OpenParol/OpenParol-Board/board/3dmodels/TLP293-4_LA-TP_E.step

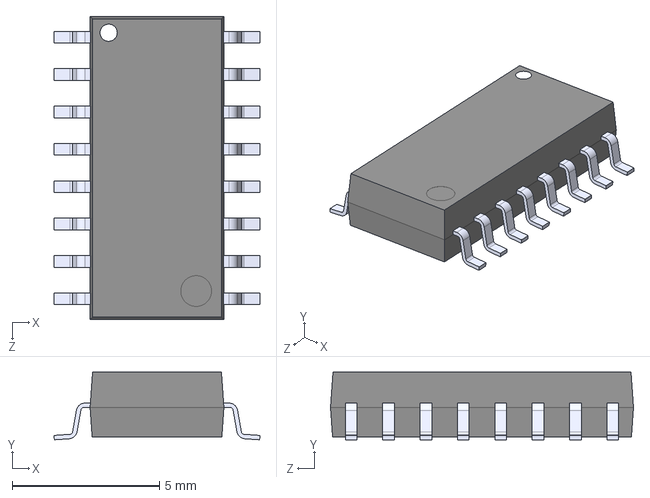
[picture p1: CAD file, 2026-10-22]
board/3dmodels/TLP293-4_LA-TP_E.step
7.00 x 2.30 x 10.3 mm
