OpenParol/OpenParol-Board/board/3dmodels/TLP281-4.step

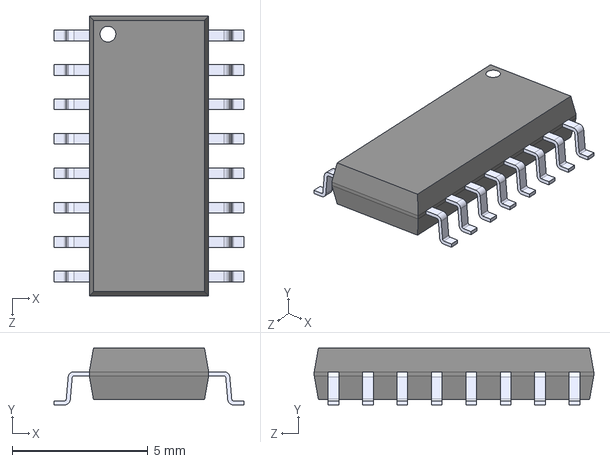
[picture p2: CAD file, 2026-10-22]
board/3dmodels/TLP281-4.step
7.00 x 2.10 x 10.3 mm
