OpenParol/OpenParol-Board/Board/3dmodels/ACT45B-510-2P-TL003.step

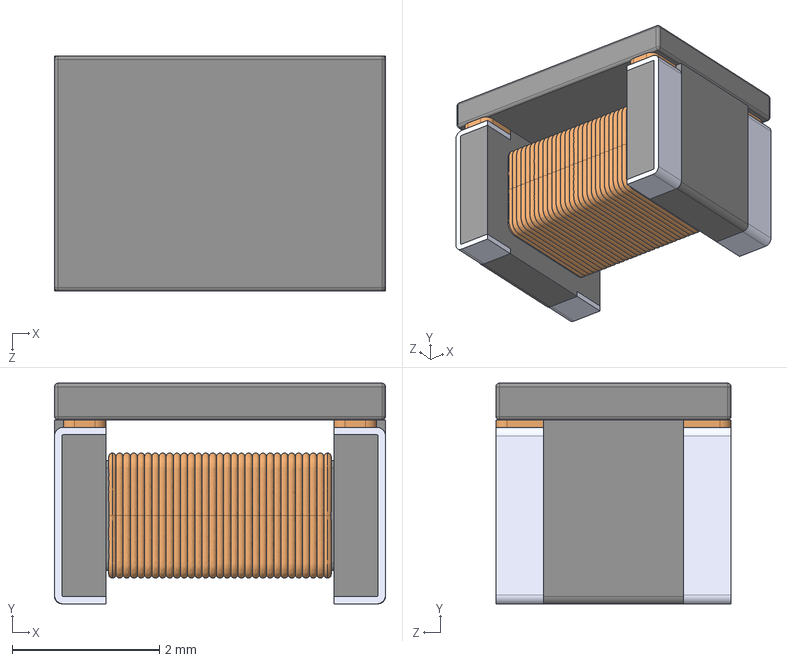
[picture p3: CAD file, 2026-10-17]
Board/3dmodels/ACT45B-510-2P-TL003.step
4.50 x 3.00 x 3.20 mm
