OpenParol/OpenParol-Board/Board/3dmodels/15EDGVC-3.81-08P-14-00A_H_.step

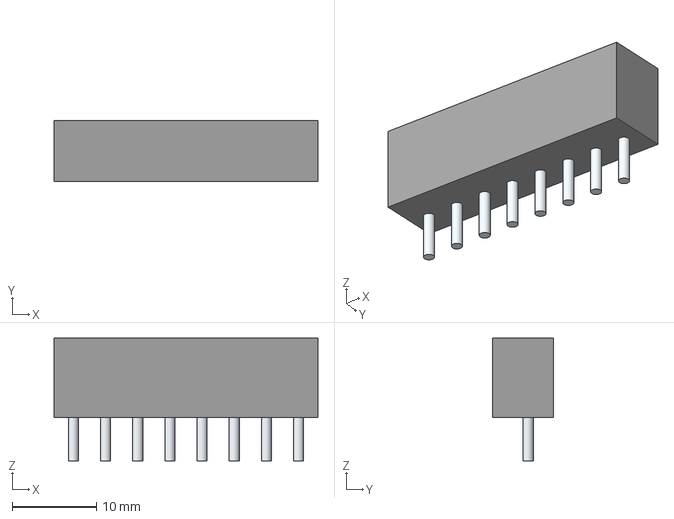
[picture p4: CAD file, 2026-10-17]
Board/3dmodels/15EDGVC-3.81-08P-14-00A_H_.step
31.3 x 7.24 x 14.5 mm
Leads
