OpenParol/OpenParol-Board/Board/3dmodels/PTS647SN50SMTR2 LFS.step

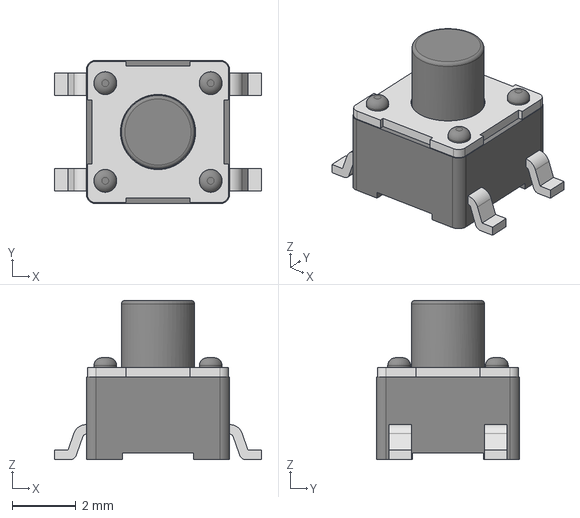
[picture p5: CAD file, 2026-10-17]
Board/3dmodels/PTS647SN50SMTR2 LFS.step
6.50 x 4.50 x 5.00 mm
