OpenParol/OpenParol-Board/Board/3dmodels/TLP3545A_TP1,F.step

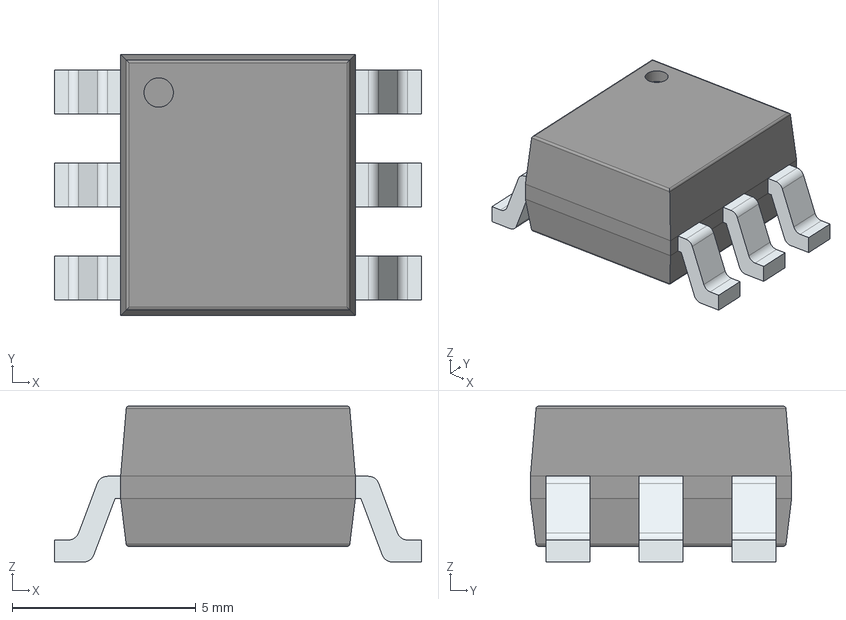
[picture p6: CAD file, 2026-10-17]
Board/3dmodels/TLP3545A_TP1,F.step
10.0 x 7.12 x 4.25 mm
PinsArrayLR
