OpenParol/OpenParol-Board/Board/3dmodels/045106.3MRL.step

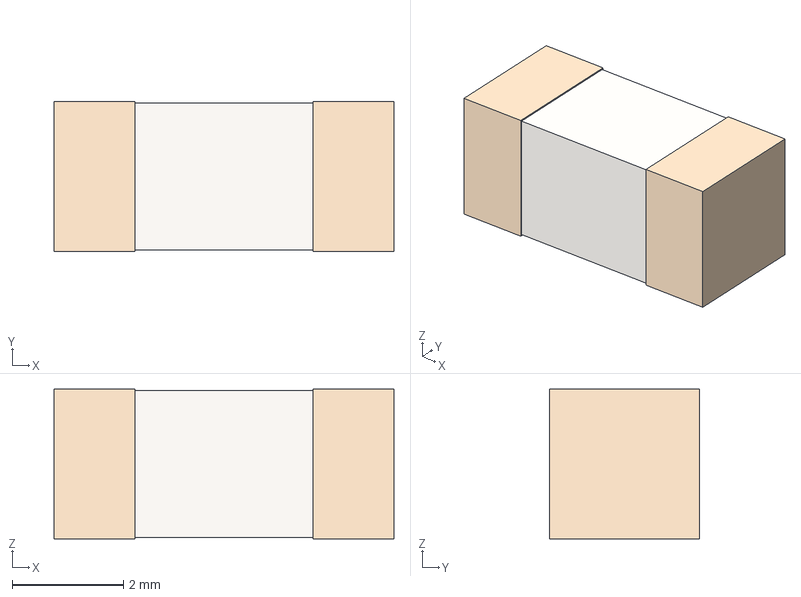
[picture p7: CAD file, 2026-10-17]
Board/3dmodels/045106.3MRL.step
6.10 x 2.69 x 2.69 mm
term1
term2
