OpenParol/OpenParol-Board/Board/3dmodels/ISO1228.step

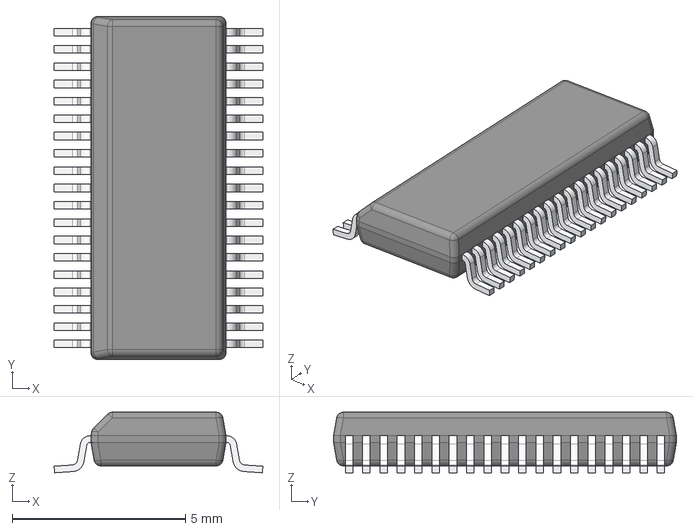
[picture p8: CAD file, 2026-10-17]
Board/3dmodels/ISO1228.step
6.03 x 9.90 x 1.75 mm
BODY-SO
LEAD-SO x 38
