OpenParol/OpenParol-Board/Board/OpenParol.kicad_pcb

## KiCad design Board/OpenParol.kicad_pcb (2026-10-17)

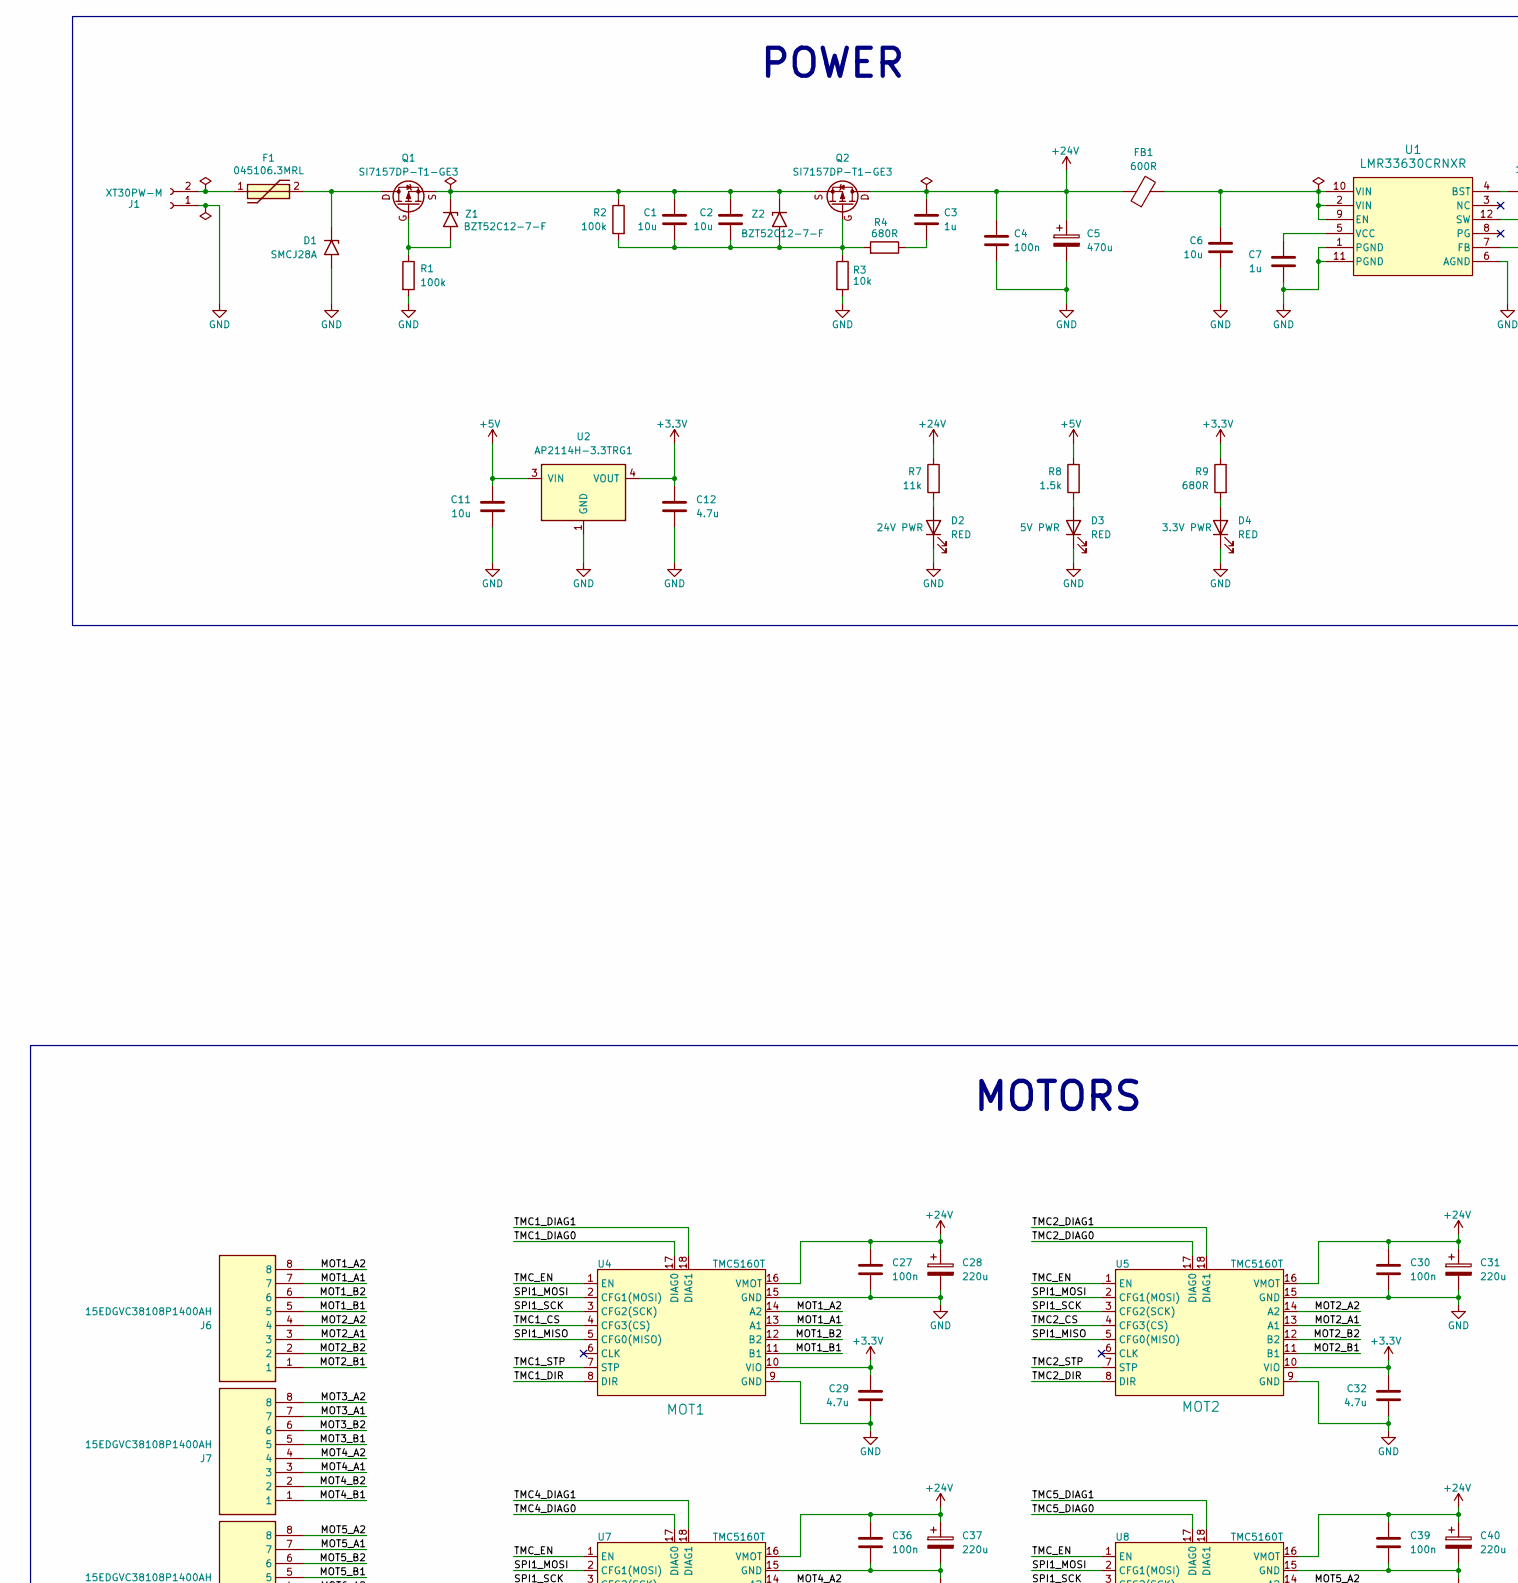
[picture p9: schematic OpenParol.kicad_sch, Control Board, part in row 1, column 1]

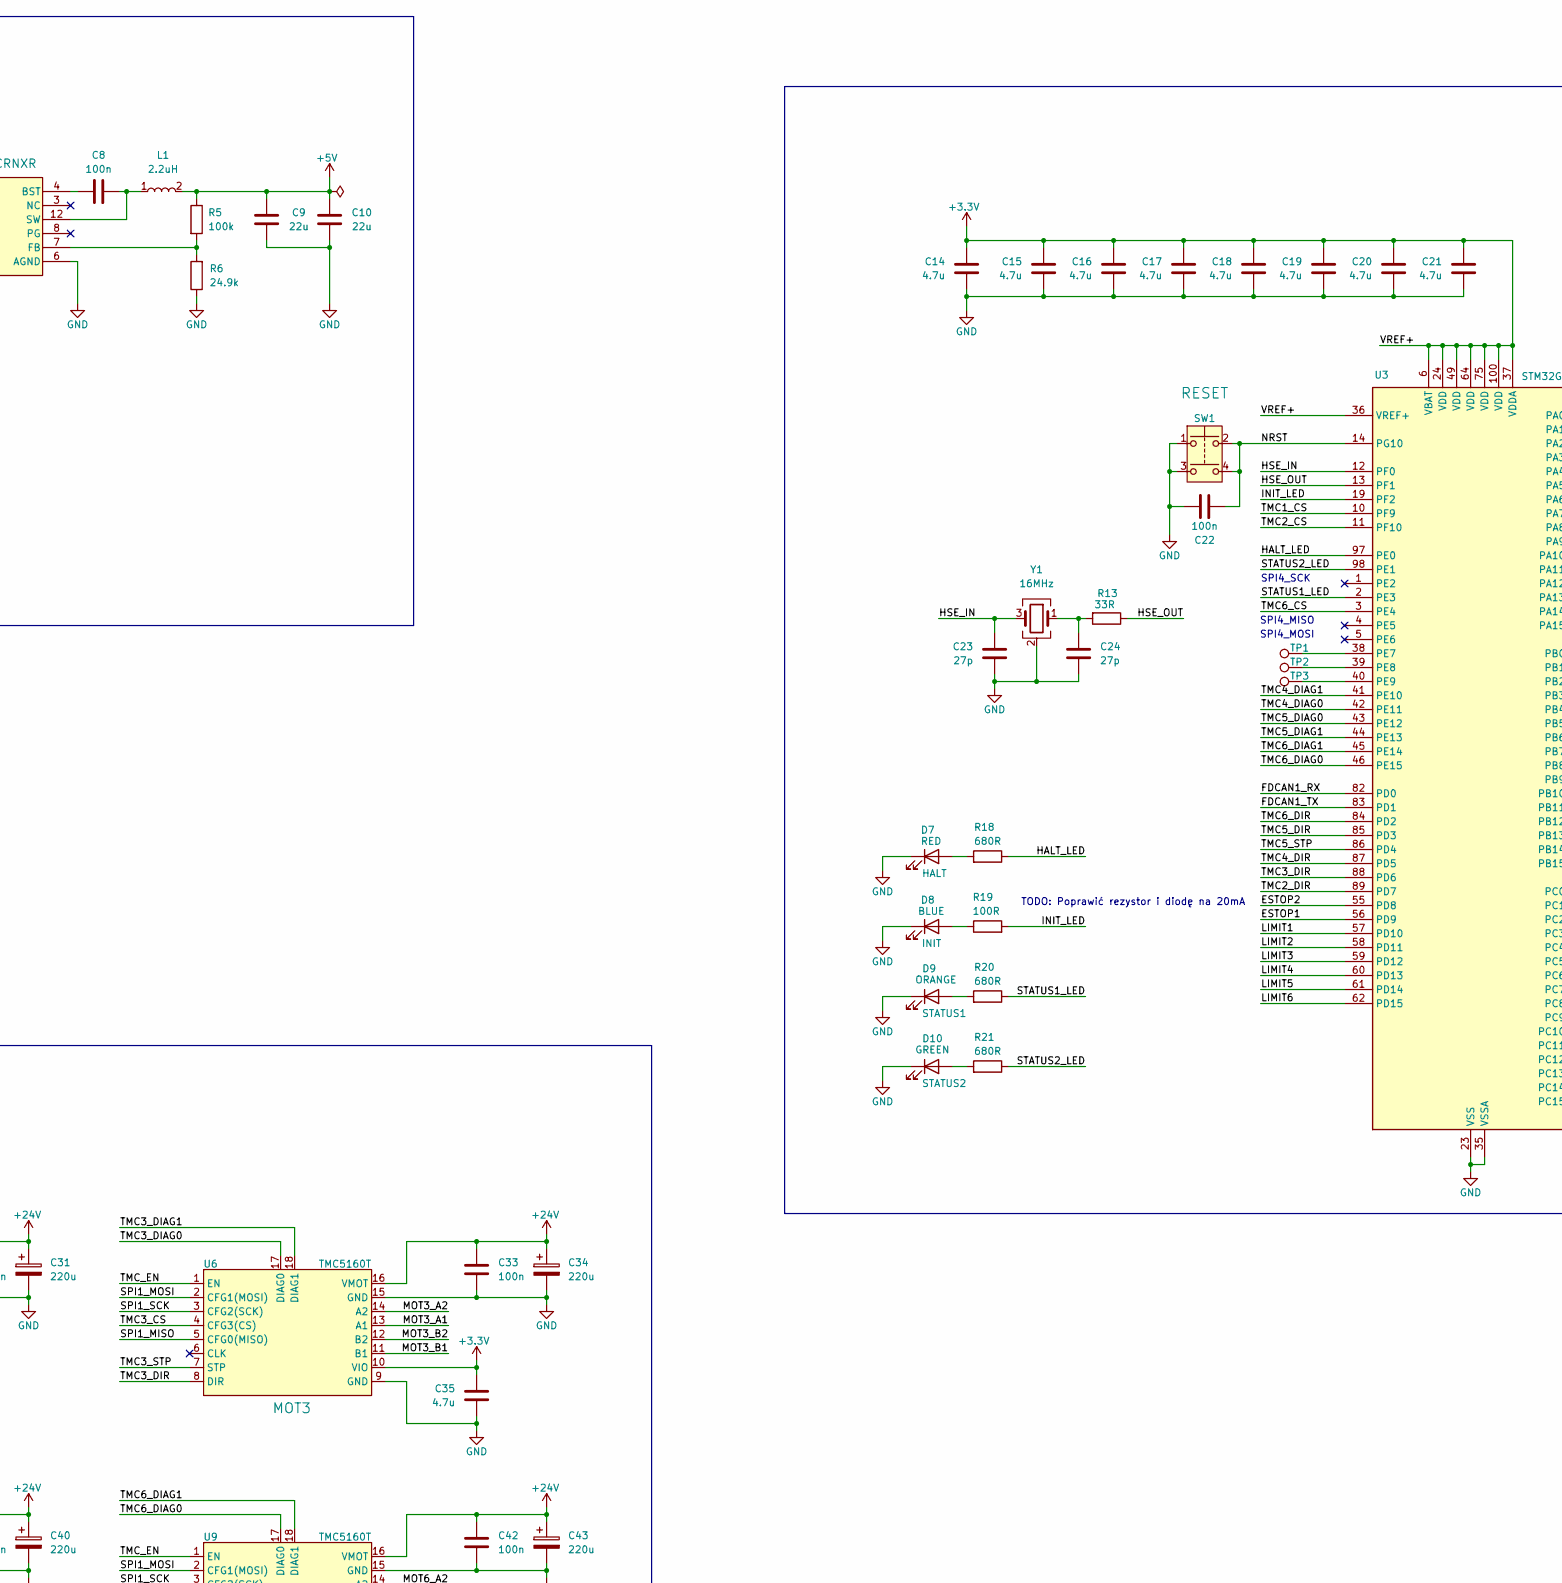
[picture p10: schematic OpenParol.kicad_sch, Control Board, part in row 1, column 2]

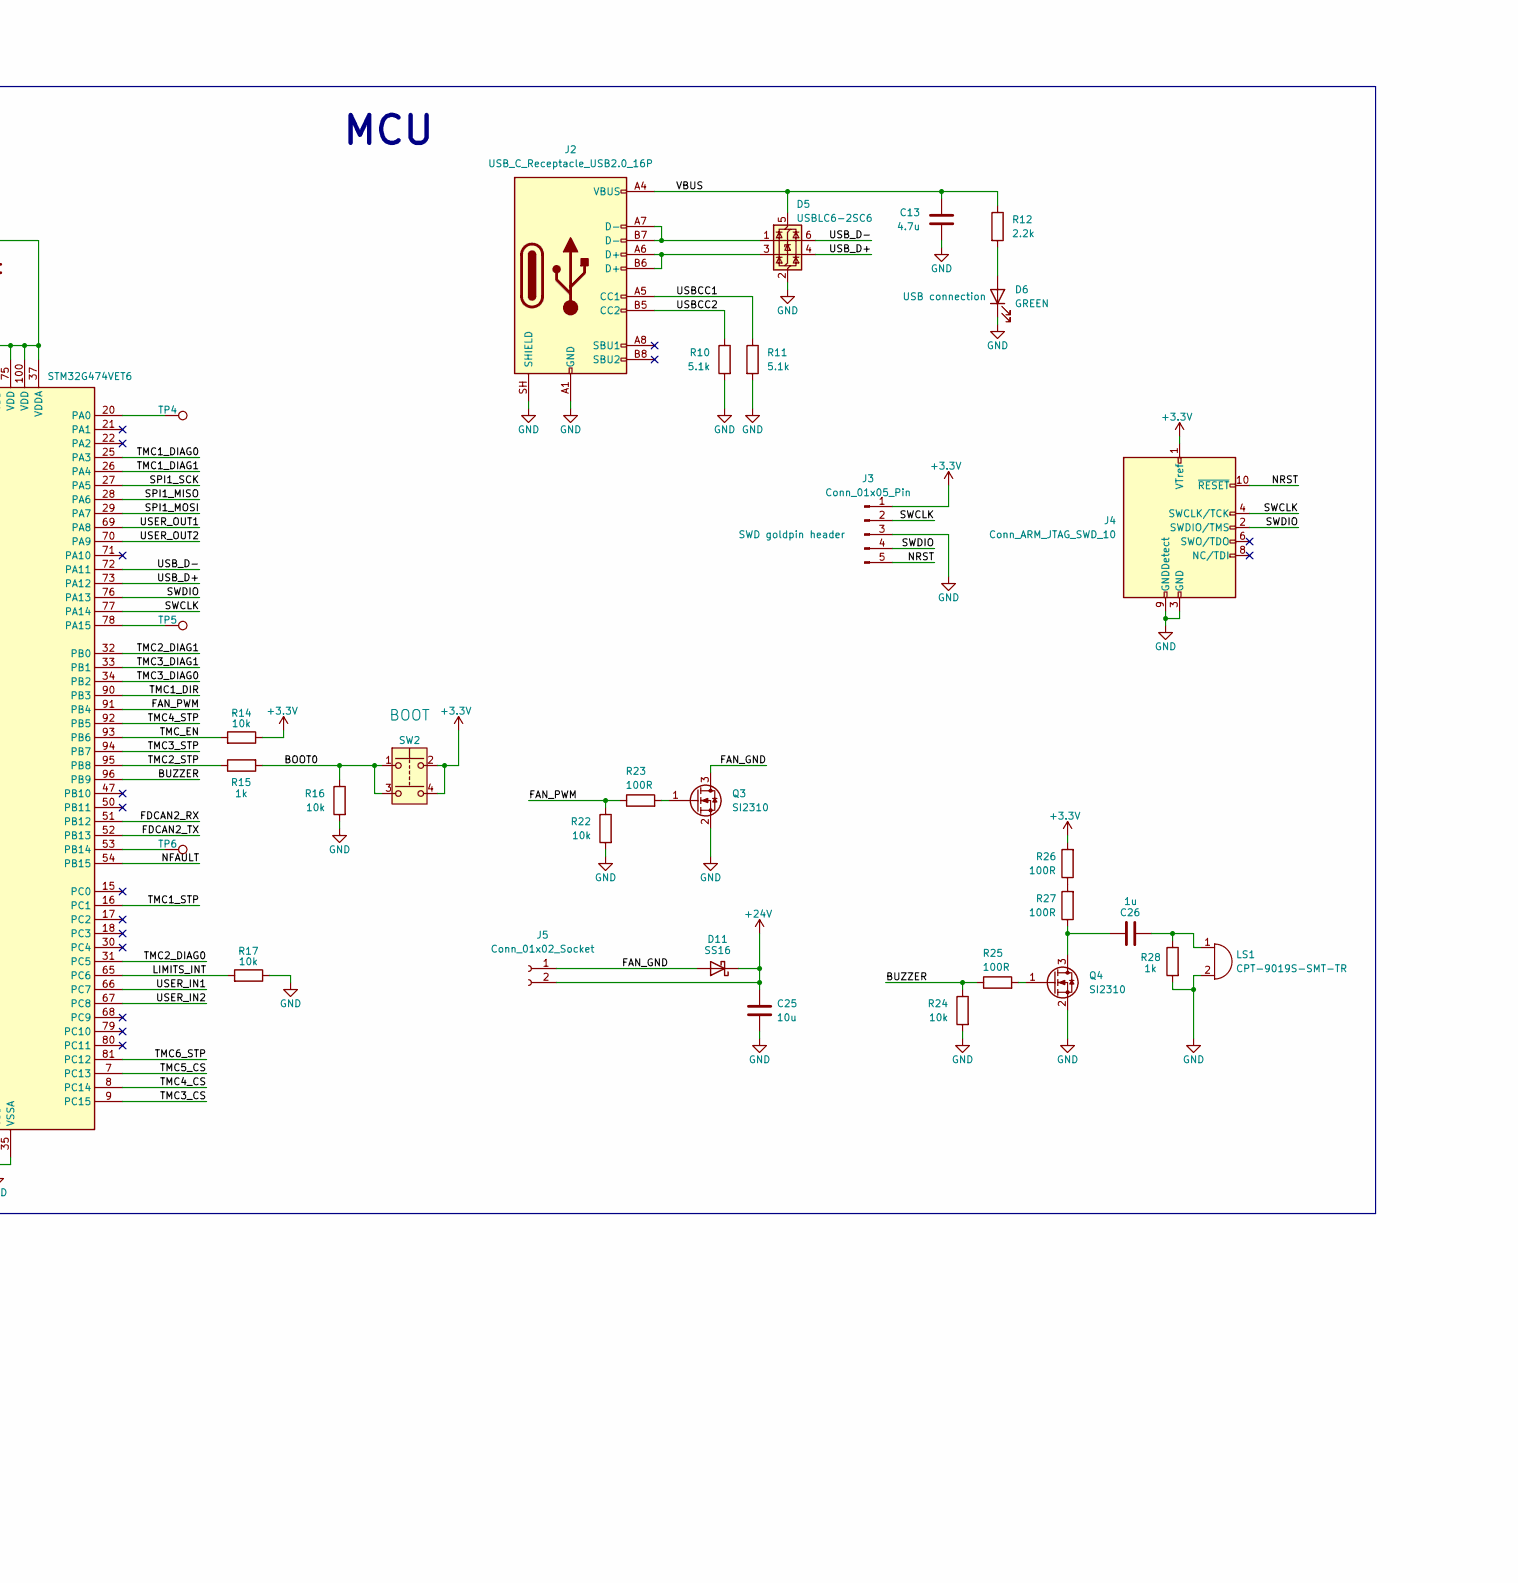
[picture p11: schematic OpenParol.kicad_sch, Control Board, part in row 1, column 3]

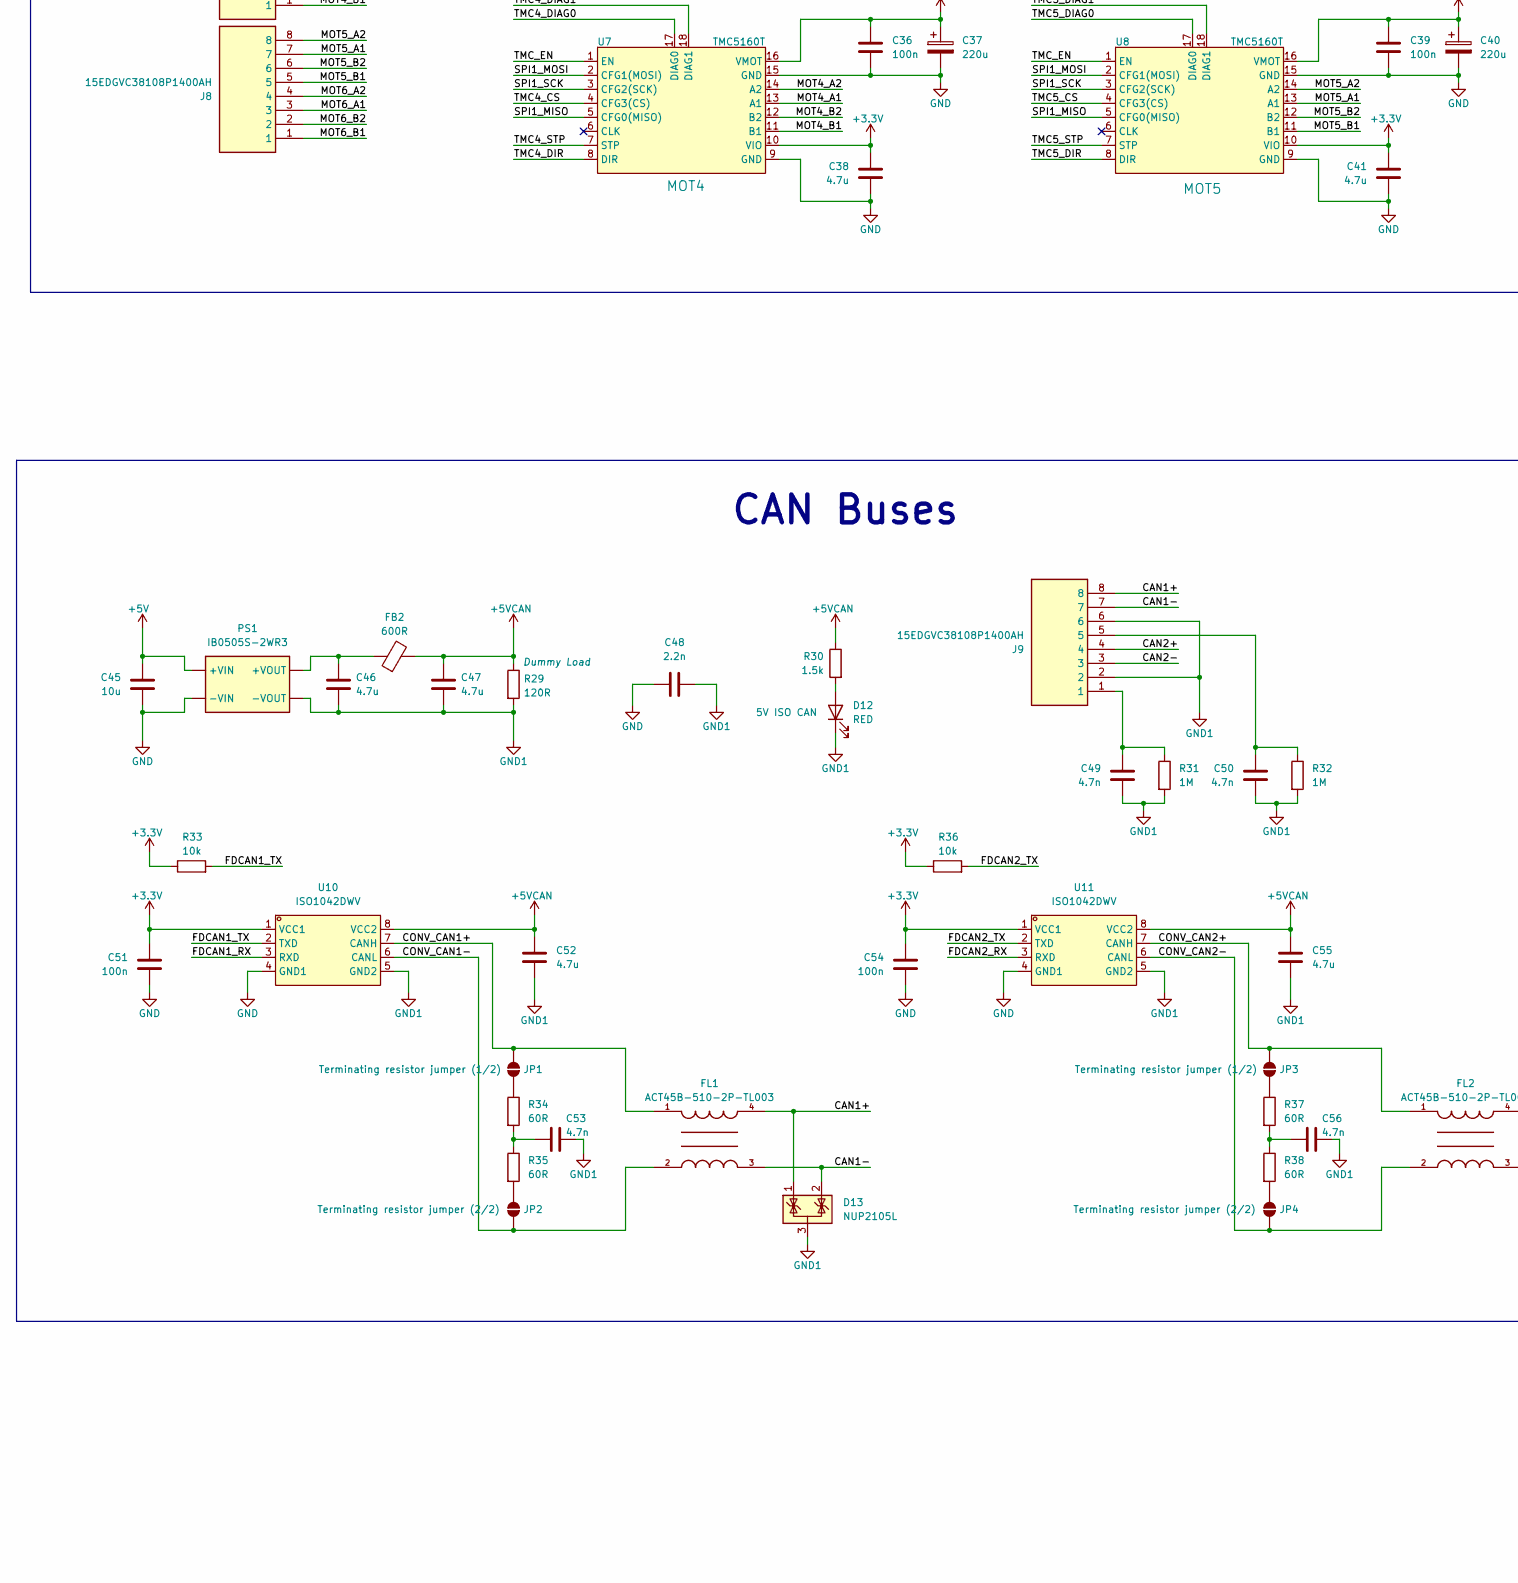
[picture p12: schematic OpenParol.kicad_sch, Control Board, part in row 2, column 1]

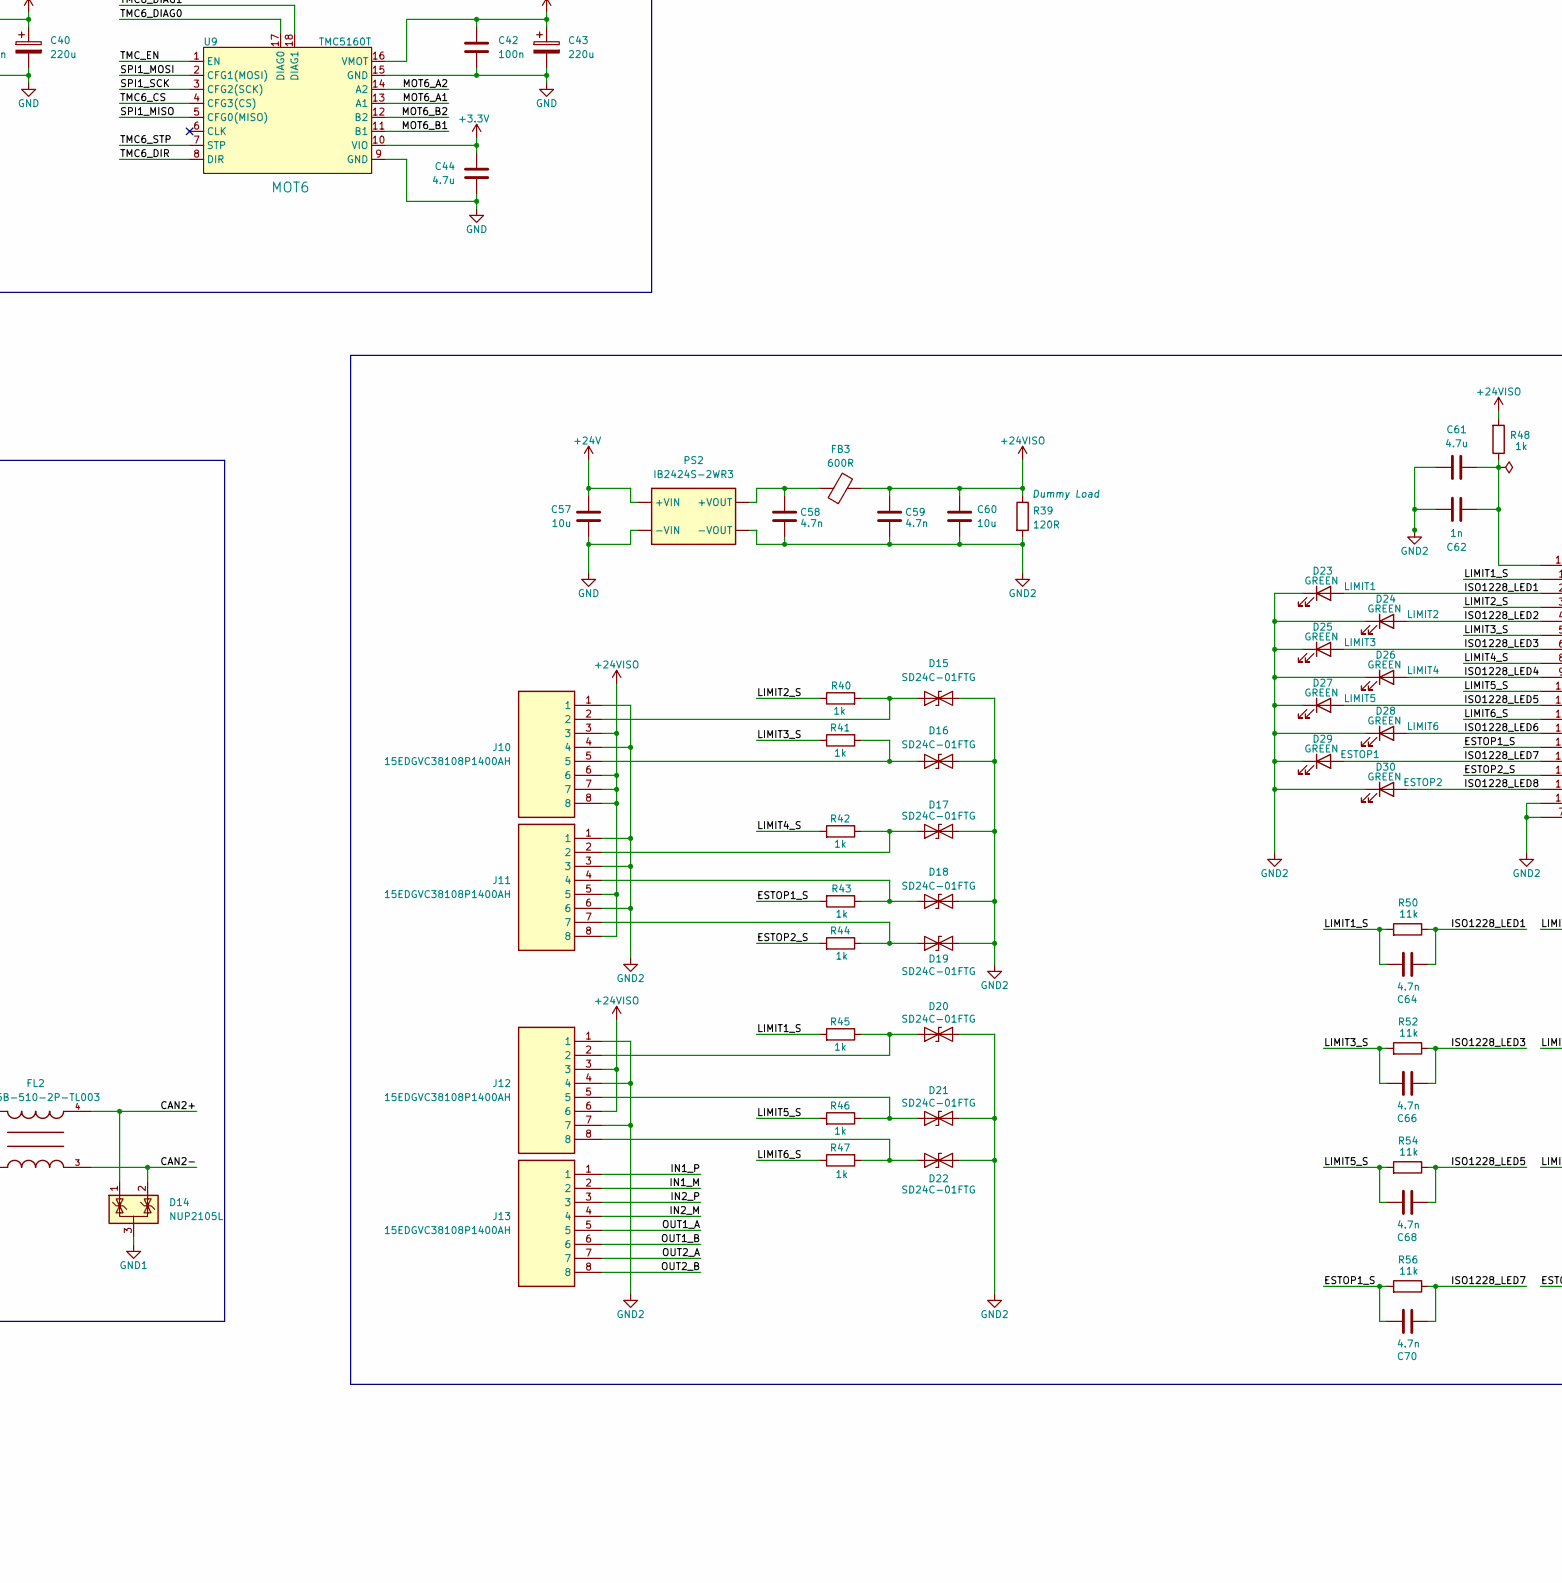
[picture p13: schematic OpenParol.kicad_sch, Control Board, part in row 2, column 2]

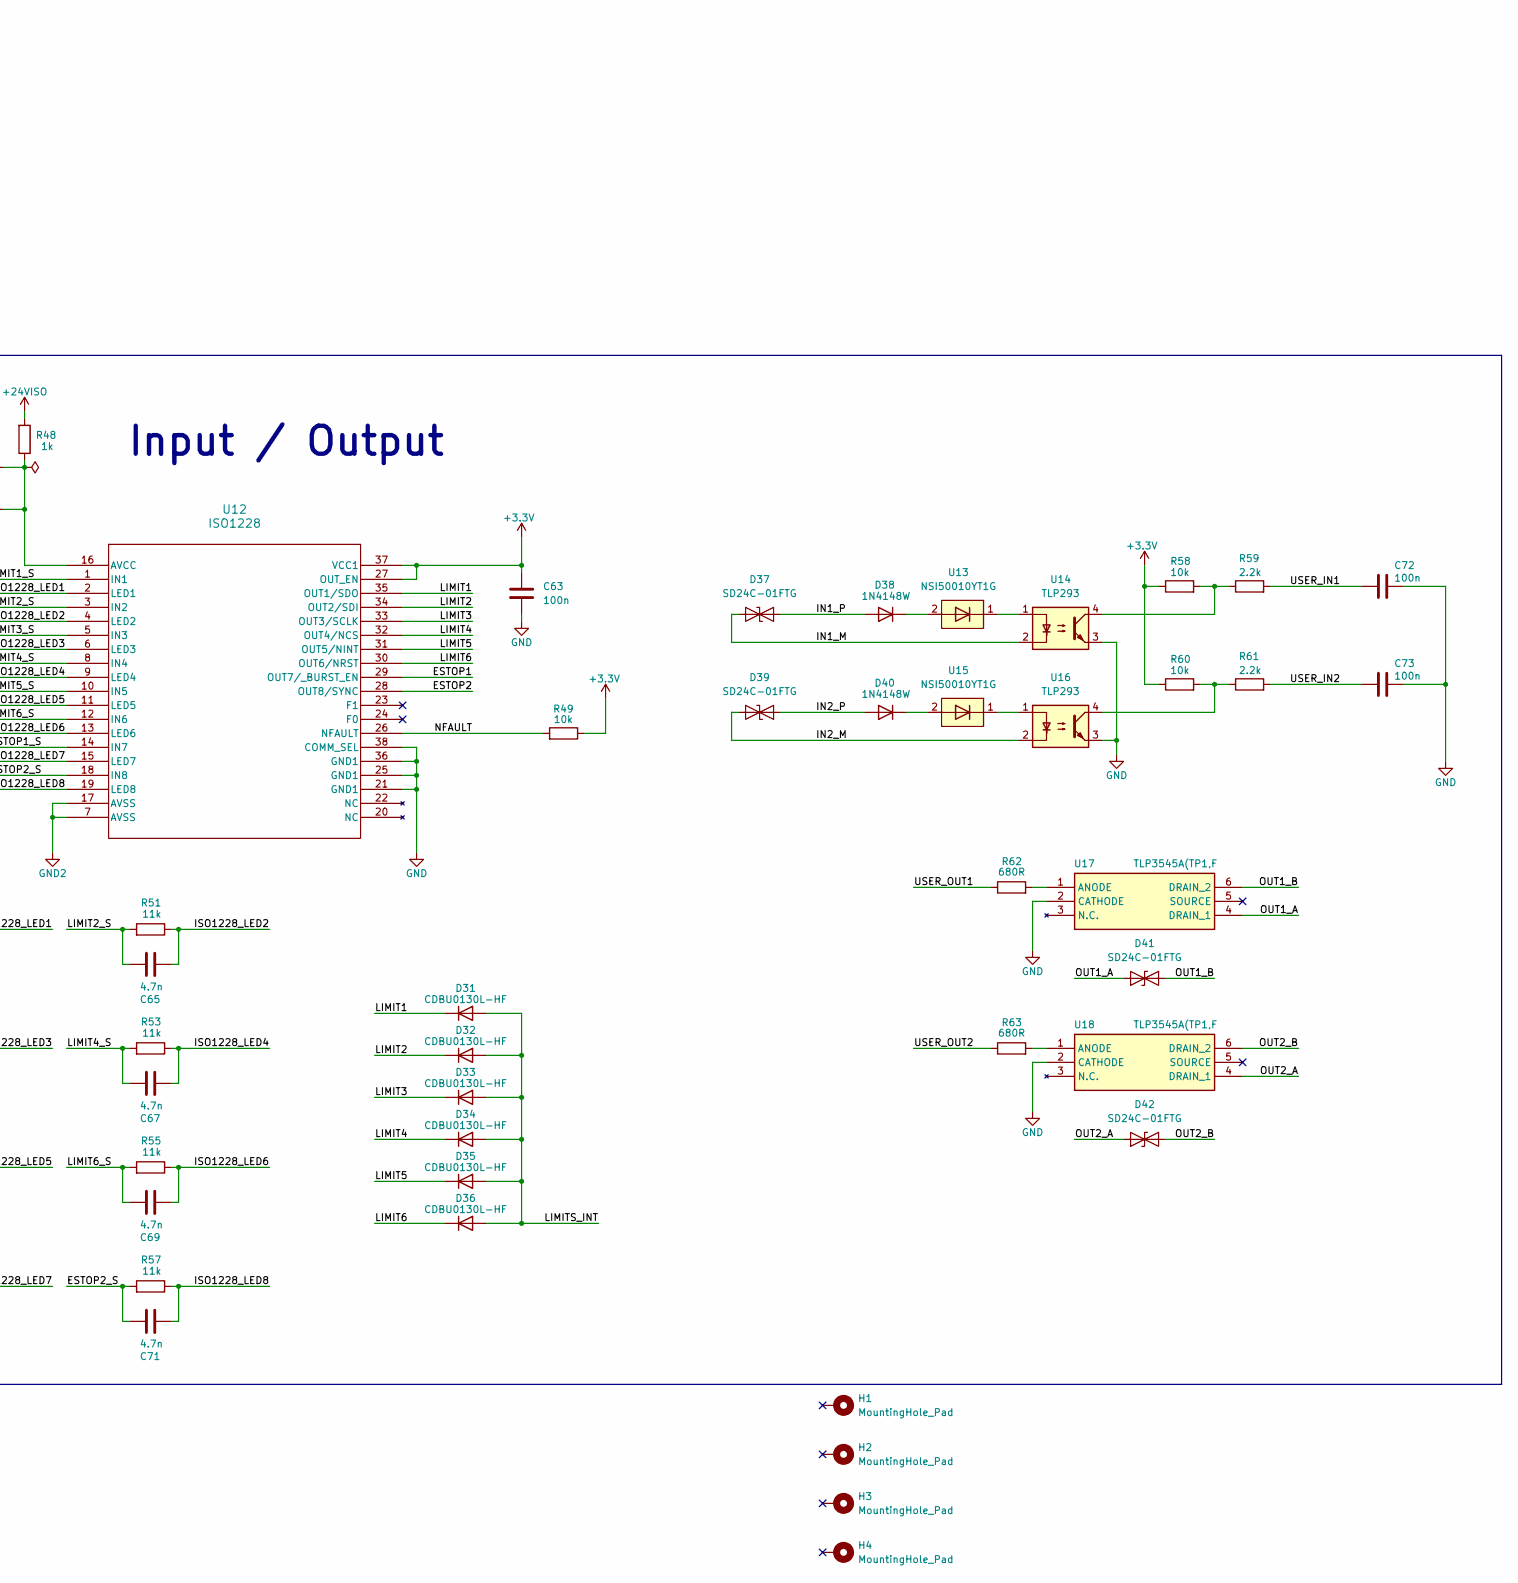
[picture p14: schematic OpenParol.kicad_sch, Control Board, part in row 2, column 3]

Parts:
C1, C2, C6, C25, C57, C60: 10u; C_1210_3225Metric_Pad1.33x2.70mm_HandSolder; MPN CL32B106KBJNNNE
C3: 1u; C_0805_2012Metric_Pad1.18x1.45mm_HandSolder; MPN C0805C105K5RACTU
C4, C27, C30, C33, C36, C39, C42: 100n; C_0805_2012Metric_Pad1.18x1.45mm_HandSolder; MPN C2012X7R2A104M125AA
C5: 470u; CP_Radial_D12.5mm_P5.00mm; MPN EKY-500ELL471MK20S
C7, C26: 1u; C_0805_2012Metric_Pad1.18x1.45mm_HandSolder; MPN GCM21BR71C105KA58K
C8, C22, C51, C54, C63, C72, C73: 100n; C_0603_1608Metric_Pad1.08x0.95mm_HandSolder; MPN 06033C104JAZ2A
C9, C10: 22u; C_1206_3216Metric_Pad1.33x1.80mm_HandSolder; MPN HGC1206R7226K160NSPJ
C11, C45: 10u; C_0805_2012Metric_Pad1.18x1.45mm_HandSolder; MPN CL21B106KOQNNNG
C12, C13, C14, C15, C16, C17, C18, C19, C20, C21, C29, C32, C35, C38, C41, C44, C46, C47, C52, C55: 4.7u; C_0603_1608Metric_Pad1.08x0.95mm_HandSolder; MPN GRM188Z71C475KE21D
C23, C24: 27p; C_0603_1608Metric_Pad1.08x0.95mm_HandSolder; MPN VJ0603D270FXBAJ
C28, C31, C34, C37, C40, C43: 220u; CP_Elec_10x10.5; MPN HV1H227M1010PZ
C48: 2.2n; C_1812_4532Metric_Pad1.57x3.40mm_HandSolder; MPN 885342211010
C49, C50: 4.7n; C_1206_3216Metric_Pad1.33x1.80mm_HandSolder; MPN 12067C472KAT2A
C53, C56, C58, C59, C64, C65, C66, C67, C68, C69, C70, C71: 4.7n; C_0603_1608Metric_Pad1.08x0.95mm_HandSolder; MPN 06035C472JAT2A
C61: 4.7u; C_0805_2012Metric_Pad1.18x1.45mm_HandSolder; MPN 0805B475K500NT
C62: 1n; C_0805_2012Metric_Pad1.18x1.45mm_HandSolder; MPN CL21B102KBANNNC
D1: SMCJ28A
D2, D3, D4, D7, D12: RED; LED_0603_1608Metric_Pad1.05x0.95mm_HandSolder; MPN SML-D14VWT86C
D5: USBLC6-2SC6; SOT-23-6
D6, D10, D23, D24, D25, D26, D27, D28, D29, D30: GREEN; LED_0603_1608Metric_Pad1.05x0.95mm_HandSolder; MPN SML-D12FWT86
D8: BLUE; LED_0603_1608Metric_Pad1.05x0.95mm_HandSolder; MPN SMLEN3BC8TT86
D9: ORANGE; LED_0603_1608Metric_Pad1.05x0.95mm_HandSolder; MPN D-060306U1/SS2/U
D11: SS16; D_SMA; MPN SS16
D13, D14: NUP2105L; SOT-23; MPN NUP2105LT1G
D15, D16, D17, D18, D19, D20, D21, D22, D37, D39, D41, D42: SD24C-01FTG; D_SOD-323; MPN SD24C-01FTG
D31, D32, D33, D34, D35, D36: CDBU0130L-HF; D_0603_1608Metric_Pad1.05x0.95mm_HandSolder; MPN CDBU0130L-HF
D38, D40: 1N4148W; D_SOD-123; MPN 1N4148W
F1: 045106.3MRL; Mouser Part Number 576-045106.3MRL
FB1, FB2, FB3: 600R; L_0805_2012Metric_Pad1.05x1.20mm_HandSolder; MPN 74279220601
FL1, FL2: ACT45B-510-2P-TL003; PARTREV 20200405
H1, H2, H3, H4: MountingHole_Pad; MountingHole_3.2mm_M3_Pad_Via
J1: XT30PW-M; AMASS_XT30PW-M_1x02_P2.50mm_Horizontal; MPN XT30PW-M
J2: USB_C_Receptacle_USB2.0_16P; USB_C_Receptacle_GCT_USB4105-xx-A_16P_TopMnt_Horizontal
J3: Conn_01x05_Pin; PinHeader_1x05_P2.54mm_Vertical
J4: Conn_ARM_JTAG_SWD_10; IDC-Header_2x05_P2.54mm_Horizontal
J5: Conn_01x02_Socket; JST_XH_B2B-XH-A_1x02_P2.50mm_Vertical
J6, J7, J8, J9, J10, J11, J12, J13: 15EDGVC38108P1400AH; Manufacturer_Part_Number 15EDGVC-3.81-08P-14-00A(H)
JP1, JP2, JP3, JP4: SolderJumper_2_Open; SolderJumper-2_P1.3mm_Open_TrianglePad1.0x1.5mm
L1: 2.2uH; SRP5030CA-2R2M; Manufacturer_Part_Number SRP5030CA-2R2M; Mouser Part Number 652-SRP5030CA-2R2M
LS1: CPT-9019S-SMT-TR; PART_REV 1.0
PS1: IB0505S-2WR3; Manufacturer_Part_Number IB0505S-2WR3
PS2: IB2424S-2WR3; Manufacturer_Part_Number IB2424S-2WR3
Q1, Q2: SI7157DP-T1-GE3; Mouser Part Number 78-SI7157DP-T1-GE3
Q3, Q4: SI2310; SOT-23-3; MPN SI2310
R1, R2, R5: 100k; R_0603_1608Metric_Pad0.98x0.95mm_HandSolder; MPN RN73H1JTTD1003B25
R3, R14, R16, R17, R22, R24, R33, R36, R49, R58, R60: 10k; R_0603_1608Metric_Pad0.98x0.95mm_HandSolder; MPN CRCW060310K0FKEAHP
R4, R9, R18, R20, R21, R62, R63: 680R; R_0603_1608Metric_Pad0.98x0.95mm_HandSolder; MPN WR06X6800FTL
R6: 24.9k; R_0603_1608Metric_Pad0.98x0.95mm_HandSolder; MPN ERA-3AEB2492V
R7, R50, R51, R52, R53, R54, R55, R56, R57: 11k; R_0603_1608Metric_Pad0.98x0.95mm_HandSolder; MPN ERA-3AEB113V
R8, R30: 1.5k; R_0603_1608Metric_Pad0.98x0.95mm_HandSolder; MPN RMCF0603FT1K50
R10, R11: 5.1k; R_0603_1608Metric_Pad0.98x0.95mm_HandSolder; MPN RK73H1JTTD5101F
R12, R59, R61: 2.2k; R_0603_1608Metric_Pad0.98x0.95mm_HandSolder; MPN CR0603-FX-2201ELF
R13: 33R; R_0603_1608Metric_Pad0.98x0.95mm_HandSolder; MPN CPF0603B33RE
R15, R28, R40, R41, R42, R43, R44, R45, R46, R47, R48: 1k; R_0603_1608Metric_Pad0.98x0.95mm_HandSolder; MPN CRGH0603F1K0
R19, R23, R25, R26, R27: 100R; R_0603_1608Metric_Pad0.98x0.95mm_HandSolder; MPN CR0603-FX-1000ELF
R29, R39: 120R; R_1206_3216Metric_Pad1.30x1.75mm_HandSolder; MPN CRGH1206J120R
R31, R32: 1M; R_1206_3216Metric_Pad1.30x1.75mm_HandSolder; MPN HV732BTTD1004F
R34, R35, R37, R38: 60R; R_0603_1608Metric_Pad0.98x0.95mm_HandSolder; MPN RTT0360R0FTP
SW1, SW2: PTS647SN50SMTR2 LFS; MPN PTS647SN50SMTR2 LFS
TP1: PE7; TestPoint_Pad_D1.5mm
TP2: PE8; TestPoint_Pad_D1.5mm
TP3: PE9; TestPoint_Pad_D1.5mm
TP4: PA0; TestPoint_Pad_D1.5mm
TP5: PA15; TestPoint_Pad_D1.5mm
TP6: PB14; TestPoint_Pad_D1.5mm
U1: LMR33630CRNXR
U2: AP2114H-3.3TRG1; Manufacturer_Part_Number AP2114H-3.3TRG1
U3: STM32G474VET6; LQFP-100_14x14mm_P0.5mm
U4, U5, U6, U7, U8, U9: TMC5160T; TMC5160T_PRO
U10, U11: ISO1042DWV; MPN ISO1042DWV
U12: ISO1228
U13, U15: NSI50010YT1G; D_SOD-123; MPN NSI50010YT1G
U14, U16: TLP293; SOIC-4_4.55x2.6mm_P1.27mm; MPN TLP293(GR-TPL,E
U17, U18: TLP3545A(TP1,F; Mouser Part Number 757-TLP3545ATP1F
Y1: 16MHz; Crystal_SMD_3225-4Pin_3.2x2.5mm; MPN 7M-16.000MAAJ-T
Z1, Z2: BZT52C12-7-F; Mouser Part Number 621-BZT52C12-F

Connections:
+3.3V: C12.1, C14.1, C15.1, C16.1, C17.1, C18.1, C19.1, C20.1, C21.1, C29.1, C32.1, C35.1, C38.1, C41.1, C44.1, C51.1, C54.1, C63.1, J3.1, J4.1 (VTref), R9.1, R14.1, R26.2, R33.1, R36.1, R49.1, R58.1, R60.1, SW2.2, SW2.4, U2.2 (VOUT), U2.4 (VOUT), U3.6 (VBAT), U3.24 (VDD), U3.36 (VREF+), U3.37 (VDDA), U3.49 (VDD), U3.64 (VDD), U3.75 (VDD), U3.100 (VDD), U4.10 (VIO), U5.10 (VIO), U6.10 (VIO), U7.10 (VIO), U8.10 (VIO), U9.10 (VIO), U10.1 (VCC1), U11.1 (VCC1), U12.27 (OUT_EN), U12.37 (VCC1)
+5V: C9.2, C10.2, C11.1, C45.1, L1.2, PS1.1 (+VIN), R5.1, R8.1, U2.3 (VIN)
+5VCAN: C47.1, C52.1, C55.1, FB2.2, R29.1, R30.1, U10.8 (VCC2), U11.8 (VCC2)
+24V: C3.1, C4.1, C5.1, C25.1, C27.1, C28.1, C30.1, C31.1, C33.1, C34.1, C36.1, C37.1, C39.1, C40.1, C42.1, C43.1, C57.1, D11.1 (K), FB1.1, J5.2, PS2.1 (+VIN), Q2.5 (D), Q2.6 (D_2), Q2.7 (D_3), Q2.8 (D_4), Q2.9 (Thermal_pad), R7.1, U4.16 (VMOT), U5.16 (VMOT), U6.16 (VMOT), U7.16 (VMOT), U8.16 (VMOT), U9.16 (VMOT)
+24VISO: C59.1, C60.1, FB3.2, J10.3, J10.6, J10.7, J10.8, J11.5, J11.8, J12.3, J12.6, R39.1, R48.2
/BOOT0: R15.2, R16.1, SW2.1, SW2.3
/BUZZER: R24.1, R25.1, U3.96 (PB9)
/CAN1+: D13.1 (K), FL1.4, J9.8
/CAN1-: D13.2 (K), FL1.3, J9.7
/CAN2+: D14.1 (K), FL2.4, J9.4
/CAN2-: D14.2 (K), FL2.3, J9.3
/CONV_CAN1+: FL1.1, JP1.2 (B), U10.7 (CANH)
/CONV_CAN1-: FL1.2, JP2.1 (A), U10.6 (CANL)
/CONV_CAN2+: FL2.1, JP3.2 (B), U11.7 (CANH)
/CONV_CAN2-: FL2.2, JP4.1 (A), U11.6 (CANL)
/ESTOP1: U3.56 (PD9), U12.29 (OUT7/_BURST_EN)
/ESTOP1_S: C70.2, R43.2, R56.2, U12.14 (IN7)
/ESTOP2: U3.55 (PD8), U12.28 (OUT8/SYNC)
/ESTOP2_S: C71.2, R44.2, R57.2, U12.18 (IN8)
/FAN_GND: D11.2 (A), J5.1, Q3.3 (D)
/FAN_PWM: R22.1, R23.1, U3.91 (PB4)
/FDCAN1_RX: U3.82 (PD0), U10.3 (RXD)
/FDCAN1_TX: R33.2, U3.83 (PD1), U10.2 (TXD)
/FDCAN2_RX: U3.51 (PB12), U11.3 (RXD)
/FDCAN2_TX: R36.2, U3.52 (PB13), U11.2 (TXD)
/HALT_LED: R18.1, U3.97 (PE0)
/HSE_IN: C23.1, U3.12 (PF0), Y1.3
/HSE_OUT: R13.1, U3.13 (PF1)
/IN1_M: D37.2 (A2), J13.2, U14.2
/IN1_P: D37.1 (A1), D38.2 (A), J13.1
/IN2_M: D39.2 (A2), J13.4, U16.2
/IN2_P: D39.1 (A1), D40.2 (A), J13.3
/INIT_LED: R19.2, U3.19 (PF2)
/ISO1228_LED1: C64.1, D23.2 (A), R50.1, U12.2 (LED1)
/ISO1228_LED2: C65.1, D24.2 (A), R51.1, U12.4 (LED2)
/ISO1228_LED3: C66.1, D25.2 (A), R52.1, U12.6 (LED3)
/ISO1228_LED4: C67.1, D26.2 (A), R53.1, U12.9 (LED4)
/ISO1228_LED5: C68.1, D27.2 (A), R54.1, U12.11 (LED5)
/ISO1228_LED6: C69.1, D28.2 (A), R55.1, U12.13 (LED6)
/ISO1228_LED7: C70.1, D29.2 (A), R56.1, U12.15 (LED7)
/ISO1228_LED8: C71.1, D30.2 (A), R57.1, U12.19 (LED8)
/LIMIT1: D31.1 (K), U3.57 (PD10), U12.35 (OUT1/SDO)
/LIMIT1_S: C64.2, R45.2, R50.2, U12.1 (IN1)
/LIMIT2: D32.1 (K), U3.58 (PD11), U12.34 (OUT2/SDI)
/LIMIT2_S: C65.2, R40.1, R51.2, U12.3 (IN2)
/LIMIT3: D33.1 (K), U3.59 (PD12), U12.33 (OUT3/SCLK)
/LIMIT3_S: C66.2, R41.1, R52.2, U12.5 (IN3)
/LIMIT4: D34.1 (K), U3.60 (PD13), U12.32 (OUT4/NCS)
/LIMIT4_S: C67.2, R42.2, R53.2, U12.8 (IN4)
/LIMIT5: D35.1 (K), U3.61 (PD14), U12.31 (OUT5/NINT)
/LIMIT5_S: C68.2, R46.2, R54.2, U12.10 (IN5)
/LIMIT6: D36.1 (K), U3.62 (PD15), U12.30 (OUT6/NRST)
/LIMIT6_S: C69.2, R47.1, R55.2, U12.12 (IN6)
/LIMITS_INT: D31.2 (A), D32.2 (A), D33.2 (A), D34.2 (A), D35.2 (A), D36.2 (A), R17.2, U3.65 (PC6)
/MOT1_A1: J6.7, U4.13 (A1)
/MOT1_A2: J6.8, U4.14 (A2)
/MOT1_B1: J6.5, U4.11 (B1)
/MOT1_B2: J6.6, U4.12 (B2)
/MOT2_A1: J6.3, U5.13 (A1)
/MOT2_A2: J6.4, U5.14 (A2)
/MOT2_B1: J6.1, U5.11 (B1)
/MOT2_B2: J6.2, U5.12 (B2)
/MOT3_A1: J7.7, U6.13 (A1)
/MOT3_A2: J7.8, U6.14 (A2)
/MOT3_B1: J7.5, U6.11 (B1)
/MOT3_B2: J7.6, U6.12 (B2)
/MOT4_A1: J7.3, U7.13 (A1)
/MOT4_A2: J7.4, U7.14 (A2)
/MOT4_B1: J7.1, U7.11 (B1)
/MOT4_B2: J7.2, U7.12 (B2)
/MOT5_A1: J8.7, U8.13 (A1)
/MOT5_A2: J8.8, U8.14 (A2)
/MOT5_B1: J8.5, U8.11 (B1)
/MOT5_B2: J8.6, U8.12 (B2)
/MOT6_A1: J8.3, U9.13 (A1)
/MOT6_A2: J8.4, U9.14 (A2)
/MOT6_B1: J8.1, U9.11 (B1)
/MOT6_B2: J8.2, U9.12 (B2)
/NFAULT: R49.2, U3.54 (PB15), U12.26 (NFAULT)
/NRST: C22.2, J3.5, J4.10 (~RESET), SW1.2, SW1.4, U3.14 (PG10)
/OUT1_A: D41.1 (A1), J13.5, U17.4 (DRAIN_1)
/OUT1_B: D41.2 (A2), J13.6, U17.6 (DRAIN_2)
/OUT2_A: D42.1 (A1), J13.7, U18.4 (DRAIN_1)
/OUT2_B: D42.2 (A2), J13.8, U18.6 (DRAIN_2)
/SPI1_MISO: U3.28 (PA6), U4.5 (CFG0(MISO)), U5.5 (CFG0(MISO)), U6.5 (CFG0(MISO)), U7.5 (CFG0(MISO)), U8.5 (CFG0(MISO)), U9.5 (CFG0(MISO))
/SPI1_MOSI: U3.29 (PA7), U4.2 (CFG1(MOSI)), U5.2 (CFG1(MOSI)), U6.2 (CFG1(MOSI)), U7.2 (CFG1(MOSI)), U8.2 (CFG1(MOSI)), U9.2 (CFG1(MOSI))
/SPI1_SCK: U3.27 (PA5), U4.3 (CFG2(SCK)), U5.3 (CFG2(SCK)), U6.3 (CFG2(SCK)), U7.3 (CFG2(SCK)), U8.3 (CFG2(SCK)), U9.3 (CFG2(SCK))
/STATUS1_LED: R20.1, U3.2 (PE3)
/STATUS2_LED: R21.1, U3.98 (PE1)
/SWCLK: J3.2, J4.4 (SWCLK/TCK), U3.77 (PA14)
/SWDIO: J3.4, J4.2 (SWDIO/TMS), U3.76 (PA13)
/TMC1_CS: U3.10 (PF9), U4.4 (CFG3(CS))
/TMC1_DIAG0: U3.25 (PA3), U4.17 (DIAG0)
/TMC1_DIAG1: U3.26 (PA4), U4.18 (DIAG1)
/TMC1_DIR: U3.90 (PB3), U4.8 (DIR)
/TMC1_STP: U3.16 (PC1), U4.7 (STP)
/TMC2_CS: U3.11 (PF10), U5.4 (CFG3(CS))
/TMC2_DIAG0: U3.31 (PC5), U5.17 (DIAG0)
/TMC2_DIAG1: U3.32 (PB0), U5.18 (DIAG1)
/TMC2_DIR: U3.89 (PD7), U5.8 (DIR)
/TMC2_STP: R15.1, U3.95 (PB8), U5.7 (STP)
/TMC3_CS: U3.9 (PC15), U6.4 (CFG3(CS))
/TMC3_DIAG0: U3.34 (PB2), U6.17 (DIAG0)
/TMC3_DIAG1: U3.33 (PB1), U6.18 (DIAG1)
/TMC3_DIR: U3.88 (PD6), U6.8 (DIR)
/TMC3_STP: U3.94 (PB7), U6.7 (STP)
/TMC4_CS: U3.8 (PC14), U7.4 (CFG3(CS))
/TMC4_DIAG0: U3.42 (PE11), U7.17 (DIAG0)
/TMC4_DIAG1: U3.41 (PE10), U7.18 (DIAG1)
/TMC4_DIR: U3.87 (PD5), U7.8 (DIR)
/TMC4_STP: U3.92 (PB5), U7.7 (STP)
/TMC5_CS: U3.7 (PC13), U8.4 (CFG3(CS))
/TMC5_DIAG0: U3.43 (PE12), U8.17 (DIAG0)
/TMC5_DIAG1: U3.44 (PE13), U8.18 (DIAG1)
/TMC5_DIR: U3.85 (PD3), U8.8 (DIR)
/TMC5_STP: U3.86 (PD4), U8.7 (STP)
/TMC6_CS: U3.3 (PE4), U9.4 (CFG3(CS))
/TMC6_DIAG0: U3.46 (PE15), U9.17 (DIAG0)
/TMC6_DIAG1: U3.45 (PE14), U9.18 (DIAG1)
/TMC6_DIR: U3.84 (PD2), U9.8 (DIR)
/TMC6_STP: U3.81 (PC12), U9.7 (STP)
/TMC_EN: R14.2, U3.93 (PB6), U4.1 (EN), U5.1 (EN), U6.1 (EN), U7.1 (EN), U8.1 (EN), U9.1 (EN)
/USBCC1: J2.A5 (CC1), R11.1
/USBCC2: J2.B5 (CC2), R10.1
/USB_D+: D5.4 (I/O2), U3.73 (PA12)
/USB_D-: D5.6 (I/O1), U3.72 (PA11)
/USER_IN1: C72.1, R59.2, U3.66 (PC7)
/USER_IN2: C73.1, R61.2, U3.67 (PC8)
/USER_OUT1: R62.1, U3.69 (PA8)
/USER_OUT2: R63.1, U3.70 (PA9)
/VBUS: C13.1, D5.5 (VBUS), J2.A4 (VBUS), J2.A9 (VBUS), J2.B4 (VBUS), J2.B9 (VBUS), R12.1
GND: C4.2, C5.2, C6.2, C7.2, C9.1, C10.1, C11.2, C12.2, C13.2, C14.2, C15.2, C16.2, C17.2, C18.2, C19.2, C20.2, C21.2, C22.1, C23.2, C24.2, C25.2, C27.2, C28.2, C29.2, C30.2, C31.2, C32.2, C33.2, C34.2, C35.2, C36.2, C37.2, C38.2, C39.2, C40.2, C41.2, C42.2, C43.2, C44.2, C45.2, C48.1, C51.2, C54.2, C57.2, C63.2, C72.2, C73.2, D1.2 (A2), D2.1 (K), D3.1 (K), D4.1 (K), D5.2 (GND), D6.1 (K), D7.1 (K), D8.1 (K), D9.1 (K), D10.1 (K), J1.1, J2.A1 (GND), J2.A12 (GND), J2.B1 (GND), J2.B12 (GND), J2.SH (SHIELD), J3.3, J4.3 (GND), J4.5 (GND), J4.9 (GNDDetect), LS1.2, PS1.2 (-VIN), PS2.2 (-VIN), Q3.2 (S), Q4.2 (S), R1.2, R3.2, R6.1, R10.2, R11.2, R16.2, R17.1, R22.2, R24.2, R28.2, SW1.1, SW1.3, U1.1 (PGND), U1.6 (AGND), U1.11 (PGND), U2.1 (GND), U3.23 (VSS), U3.35 (VSSA), U3.48 (VSS), U3.63 (VSS), U3.74 (VSS), U3.99 (VSS), U4.9 (GND), U4.15 (GND), U5.9 (GND), U5.15 (GND), U6.9 (GND), U6.15 (GND), U7.9 (GND), U7.15 (GND), U8.9 (GND), U8.15 (GND), U9.9 (GND), U9.15 (GND), U10.4 (GND1), U11.4 (GND1), U12.21 (GND1), U12.25 (GND1), U12.36 (GND1), U12.38 (COMM_SEL), U14.3, U16.3, U17.2 (CATHODE), U18.2 (CATHODE), Y1.2 (G), Y1.4 (G)
GND1: C46.2, C47.2, C48.2, C49.2, C50.2, C52.2, C53.1, C55.2, C56.1, D12.1 (K), D13.3 (A), D14.3 (A), J9.2, J9.6, PS1.3 (-VOUT), R29.2, R31.2, R32.2, U10.5 (GND2), U11.5 (GND2)
GND2: C58.2, C59.2, C60.2, C61.1, C62.1, D15.2 (A2), D16.2 (A2), D17.2 (A2), D18.2 (A2), D19.2 (A2), D20.2 (A2), D21.2 (A2), D22.2 (A2), D23.1 (K), D24.1 (K), D25.1 (K), D26.1 (K), D27.1 (K), D28.1 (K), D29.1 (K), D30.1 (K), J10.1, J10.4, J11.1, J11.3, J11.6, J12.1, J12.4, J12.7, PS2.3 (-VOUT), R39.2, U12.7 (AVSS), U12.17 (AVSS)
unnamed: C3.2, R4.1
unnamed: C24.1, R13.2, Y1.1
unnamed: C26.2, LS1.1, R28.1
unnamed: C49.1, J9.1, R31.1
unnamed: C50.1, J9.5, R32.1
unnamed: C53.2, R34.2, R35.1
unnamed: C56.2, R37.2, R38.1
unnamed: D1.1 (A1), F1.2, Q1.5 (D), Q1.6 (D_2), Q1.7 (D_3), Q1.8 (D_4), Q1.9 (Thermal_pad)
unnamed: D2.2 (A), R7.2
unnamed: D3.2 (A), R8.2
unnamed: D4.2 (A), R9.2
unnamed: D5.1 (I/O1), J2.A7 (D-), J2.B7 (D-)
unnamed: D5.3 (I/O2), J2.A6 (D+), J2.B6 (D+)
unnamed: D6.2 (A), R12.2
unnamed: D7.2 (A), R18.2
unnamed: D8.2 (A), R19.1
unnamed: D9.2 (A), R20.2
unnamed: D10.2 (A), R21.2
unnamed: D12.2 (A), R30.2
unnamed: D15.1 (A1), J10.2, R40.2
unnamed: D16.1 (A1), J10.5, R41.2
unnamed: D17.1 (A1), J11.2, R42.1
unnamed: D18.1 (A1), J11.4, R43.1
unnamed: D19.1 (A1), J11.7, R44.1
unnamed: D20.1 (A1), J12.2, R45.1
unnamed: D21.1 (A1), J12.5, R46.1
unnamed: D22.1 (A1), J12.8, R47.2
unnamed: D38.1 (K), U13.2
unnamed: D40.1 (K), U15.2
unnamed: F1.1, J1.2
unnamed: JP1.1 (A), R34.1
unnamed: JP2.2 (B), R35.2
unnamed: JP3.1 (A), R37.1
unnamed: JP4.2 (B), R38.2
unnamed: C46.1, FB2.1, PS1.4 (+VOUT)
unnamed: C58.1, FB3.1, PS2.4 (+VOUT)
unnamed: Q1.4 (G), R1.1, Z1.2 (A2)
unnamed: C1.1, C2.1, Q1.1 (S_1), Q1.2 (S_2), Q1.3 (S_3), Q2.1 (S_1), Q2.2 (S_2), Q2.3 (S_3), R2.1, Z1.1 (A1), Z2.1 (A1)
unnamed: C1.2, C2.2, Q2.4 (G), R2.2, R3.1, R4.2, Z2.2 (A2)
unnamed: Q3.1 (G), R23.2
unnamed: C26.1, Q4.3 (D), R27.1
unnamed: Q4.1 (G), R25.2
unnamed: R26.1, R27.2
unnamed: R58.2, R59.1, U14.4
unnamed: R60.2, R61.1, U16.4
unnamed: C8.1, U1.4 (BST)
unnamed: C6.1, FB1.2, U1.2 (VIN), U1.9 (EN), U1.10 (VIN)
unnamed: R5.2, R6.2, U1.7 (FB)
unnamed: C8.2, L1.1, U1.12 (SW)
unnamed: C7.1, U1.5 (VCC)
unnamed: TP4.1 (1_1), U3.20 (PA0)
unnamed: TP5.1 (1_1), U3.78 (PA15)
unnamed: TP6.1 (1_1), U3.53 (PB14)
unnamed: TP1.1 (1_1), U3.38 (PE7)
unnamed: TP2.1 (1_1), U3.39 (PE8)
unnamed: TP3.1 (1_1), U3.40 (PE9)
unnamed: C61.2, C62.2, R48.1, U12.16 (AVCC)
unnamed: U13.1, U14.1
unnamed: U15.1, U16.1
unnamed: R62.2, U17.1 (ANODE)
unnamed: R63.2, U18.1 (ANODE)

Notes on the sheet:
CAN Buses
MCU
TODO: Poprawić rezystor i diodę na 20mA
POWER
Input / Output
SPI4_MOSI
SPI4_SCK
SPI4_MISO
MOTORS

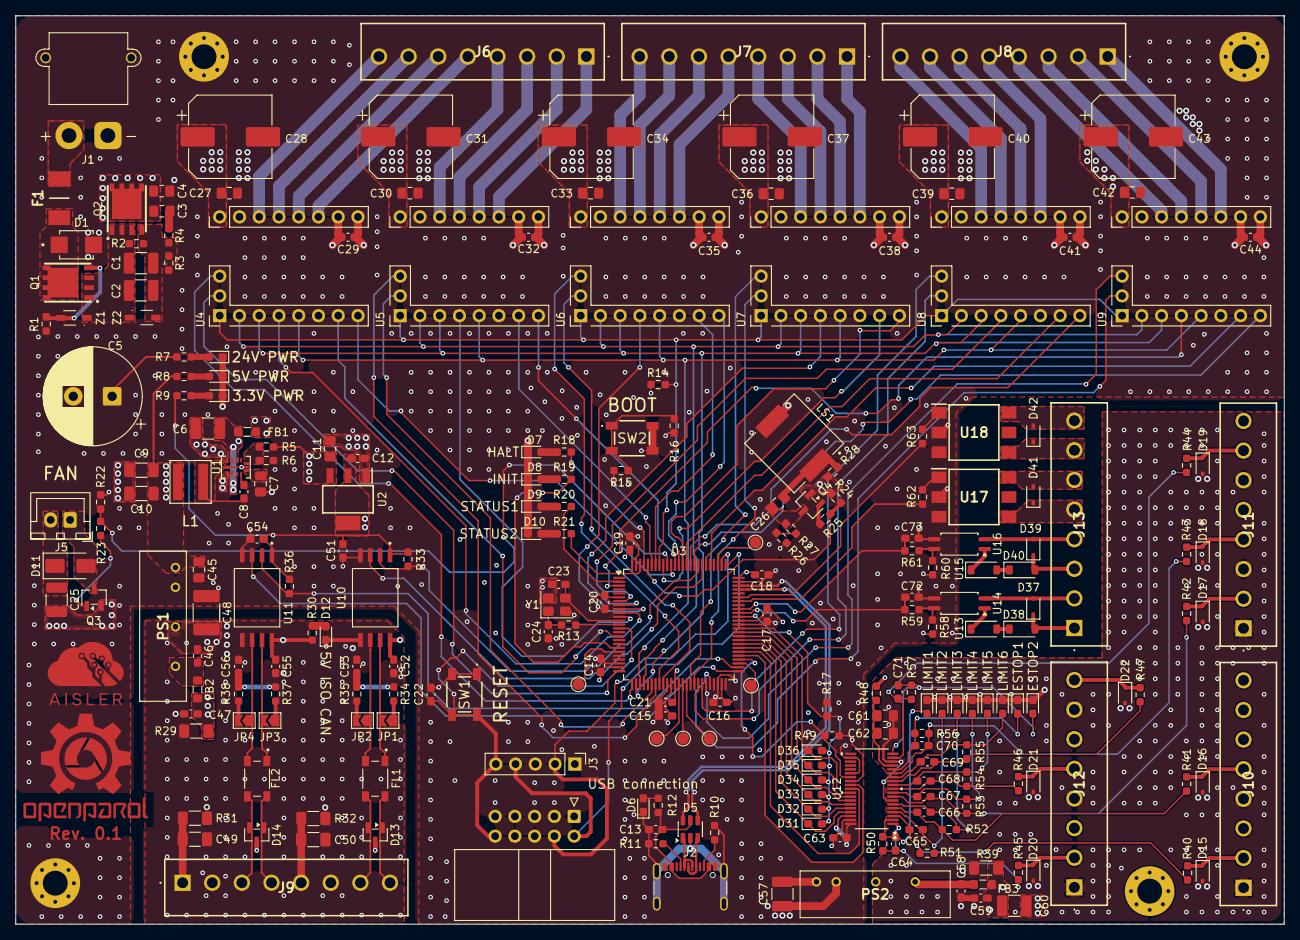
[picture p15: board OpenParol.kicad_pcb from above]

Board: 4 copper layers, 163.1 x 116.8 mm, 242 parts (0 on the bottom side), 195 nets.
